Qualot/open_knee_joint_cad/step/Femur/femur_condyle_mir.step

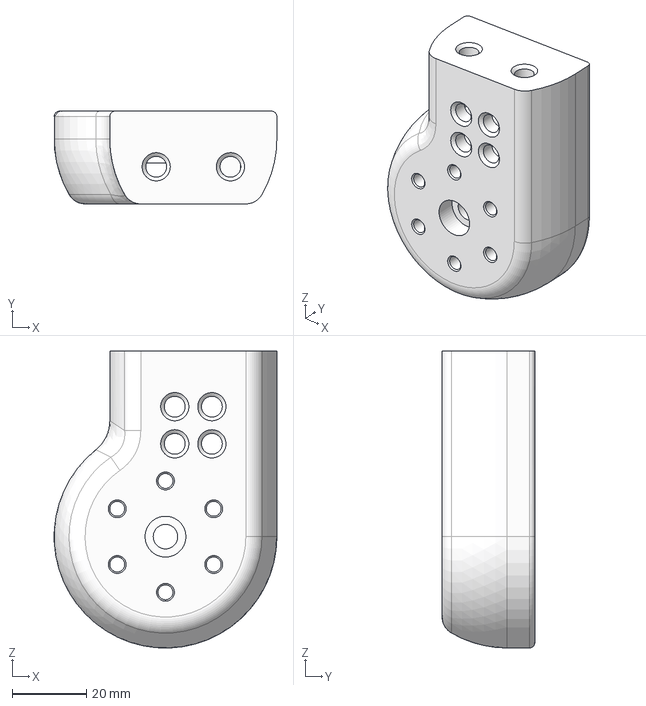
[picture p3: CAD file, 2026-10-14]
step/Femur/femur_condyle_mir.step
60.0 x 25.0 x 80.0 mm
