Qualot/open_knee_joint_cad/step/Linkage/Link_50sqrt2.step

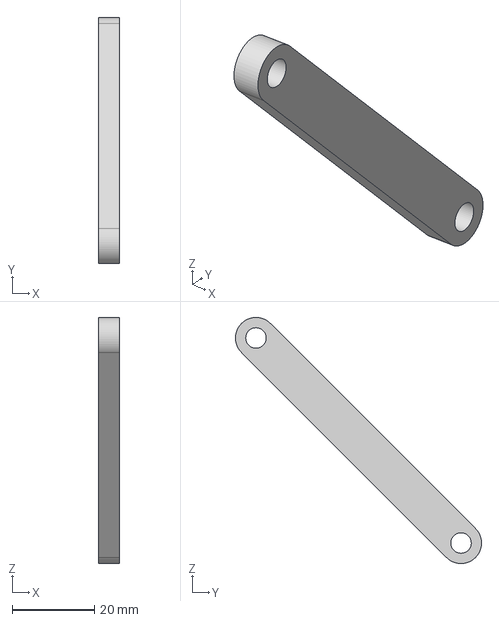
[picture p4: CAD file, 2026-10-14]
step/Linkage/Link_50sqrt2.step
5.00 x 60.0 x 60.0 mm
