Qualot/open_knee_joint_cad/step/Tibia/frame_connector.step

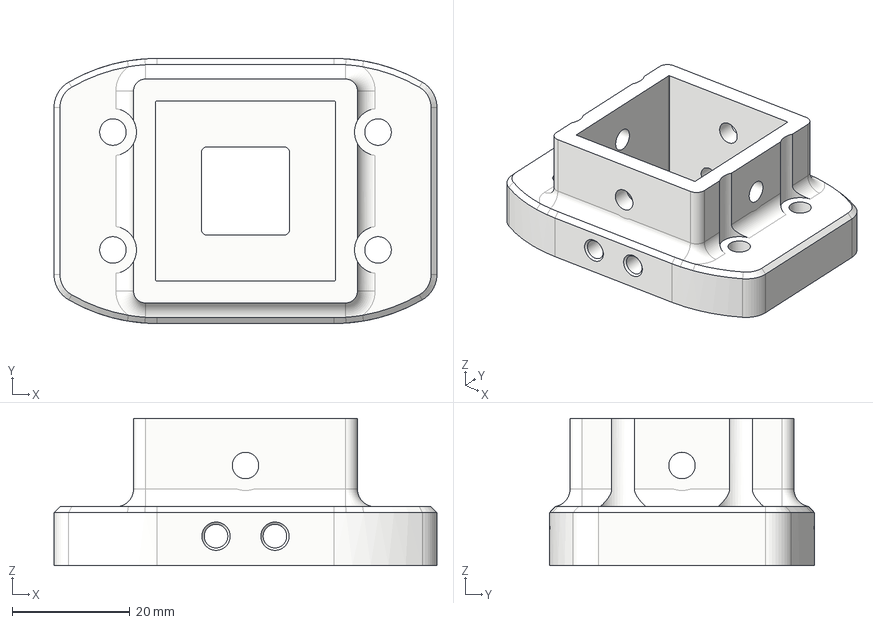
[picture p5: CAD file, 2026-10-14]
step/Tibia/frame_connector.step
65.0 x 45.0 x 25.0 mm
