Qualot/open_knee_joint_cad/step/Linkage/Link_50.step

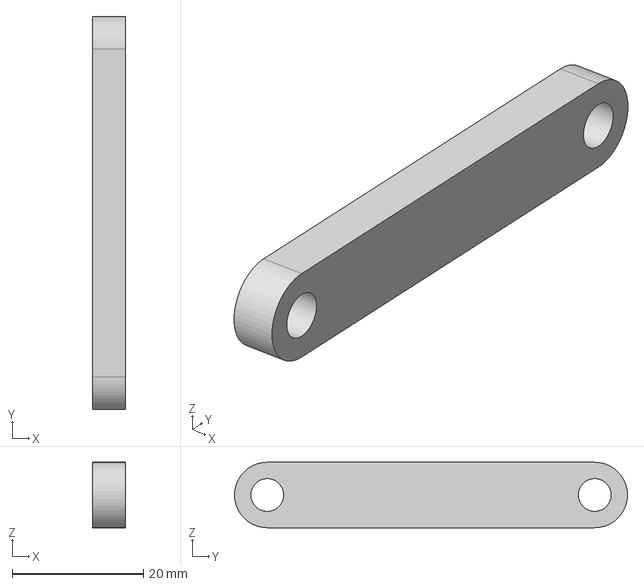
[picture p6: CAD file, 2026-10-14]
step/Linkage/Link_50.step
5.00 x 60.0 x 10.0 mm
