Qualot/open_knee_joint_cad/step/Tibia/tibia_condyle.step

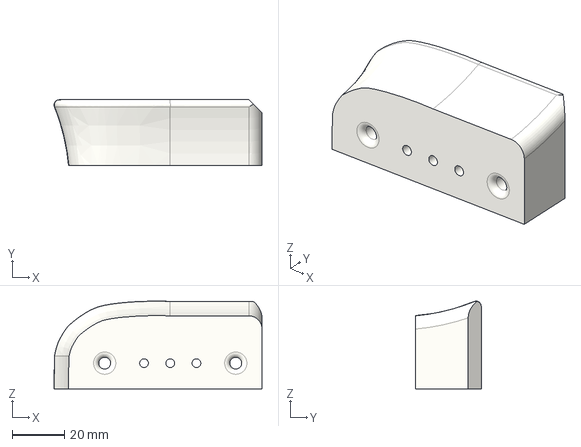
[picture p7: CAD file, 2026-10-14]
step/Tibia/tibia_condyle.step
79.3 x 25.0 x 33.5 mm
