Qualot/open_knee_joint_cad/step/Tibia/tibia_plate_mir.step

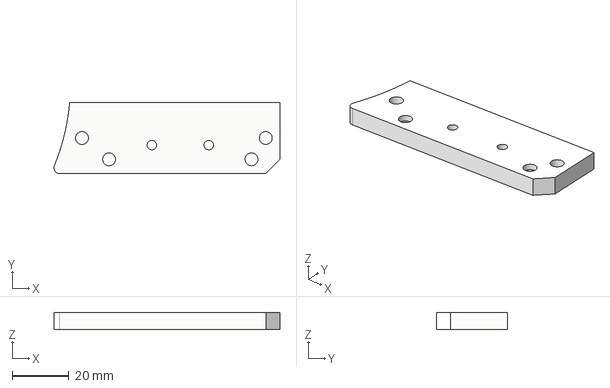
[picture p8: CAD file, 2026-10-14]
step/Tibia/tibia_plate_mir.step
79.3 x 25.0 x 6.00 mm
