Qualot/open_knee_joint_cad/(list of files, cad)

Other CAD files:
step/Femur/femur_condyle.step
step/Tibia/tibia_condyle_mir.step
step/Tibia/tibia_plate.step
step/Femur/femur_condyle.stl
step/Linkage/Link_50sqrt2.stl
step/Tibia/tibia_plate.stl
step/Tibia/tibia_plate_mir.stl
stl/Femur/femur_condyle_mir.stl
stl/Linkage/Link_50.stl
stl/Tibia/frame_connector.stl
stl/Tibia/tibia_condyle.stl
stl/Tibia/tibia_condyle_mir.stl
