Qualot/open_knee_joint_cad/(commit log)

2026-10-14 Add citation section to README
    Added citation information for published research related to the CAD file.
2026-10-14 Enhance README with publication DOI link
    Added publication reference for the CAD file.
2026-10-14 Add cad files, step and stl
2026-10-14 Update README with publication details and citation
    Added authors and citation details for the CAD file.
